bullestock/remote/mainboard-split/mainboard.kicad_pcb

## KiCad design mainboard-split/mainboard.kicad_pcb (2024-12-09)

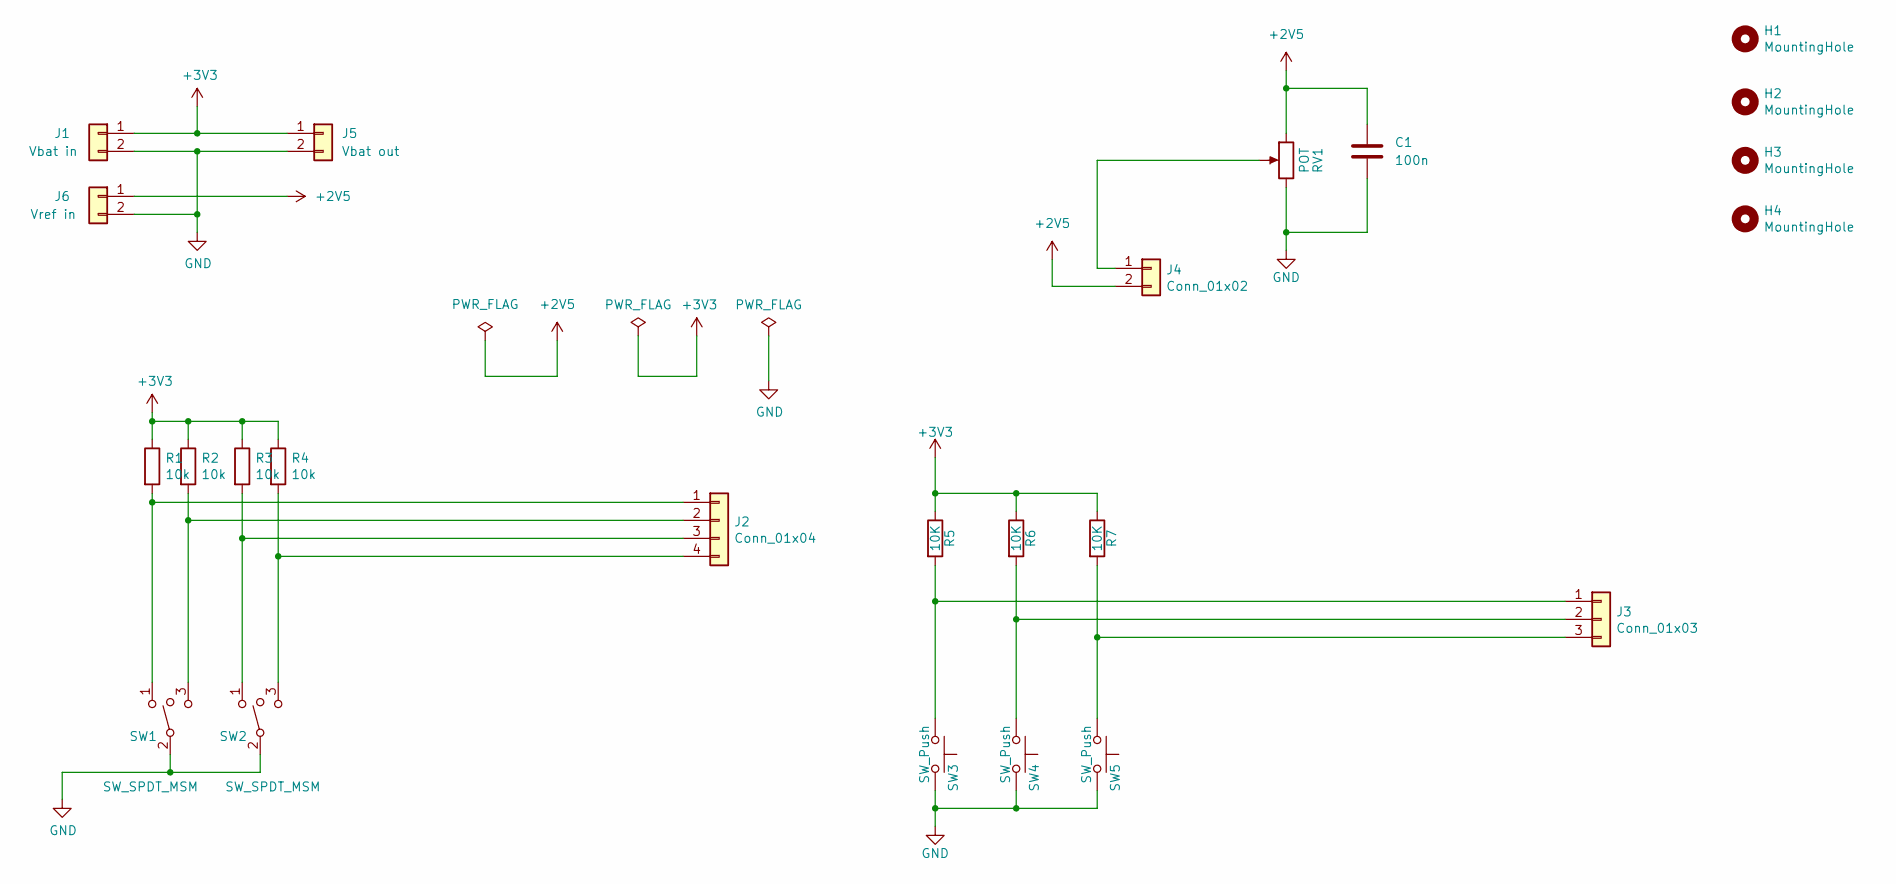
[picture p1: schematic mainboard.kicad_sch]

Parts:
C1: 100n; C_0603_1608Metric
H1, H2, H3, H4: MountingHole; MountingHole_3.2mm_M3
J1: Vbat in; JST_XH_B02B-XH-A_1x02_P2.50mm_Vertical
J2: Conn_01x04; JST_XH_B04B-XH-A_1x04_P2.50mm_Vertical
J3: Conn_01x03; JST_XH_B03B-XH-A_1x03_P2.50mm_Vertical
J4: Conn_01x02; JST_XH_B02B-XH-A_1x02_P2.50mm_Vertical
J5: Vbat out; JST_XH_B02B-XH-A_1x02_P2.50mm_Vertical
J6: Vref in; JST_XH_B02B-XH-A_1x02_P2.50mm_Vertical
R1, R2, R3, R4: 10k; R_0603_1608Metric
R5, R6, R7: 10K; R_0603_1608Metric
RV1: POT; Potentiometer_6mm_axis_square
SW1, SW2: SW_SPDT_MSM; Switch_1x03_P5.08mm
SW3, SW4, SW5: SW_Push; Switch_1x02_P6mm

Connections:
+2V5: C1.1, J4.2, J6.1, RV1.1
+3V3: J1.1, J5.1, R1.1, R2.1, R3.1, R4.1, R5.1, R6.1, R7.1
GND: C1.2, J1.2, J5.2, J6.2, RV1.3, SW1.2, SW2.2, SW3.2, SW4.2, SW5.2
unnamed: J2.1, R1.2, SW1.1
unnamed: J2.2, R2.2, SW1.3
unnamed: J2.3, R3.2, SW2.1
unnamed: J2.4, R4.2, SW2.3
unnamed: J3.1, R5.2, SW3.1
unnamed: J3.2, R6.2, SW4.1
unnamed: J3.3, R7.2, SW5.1
unnamed: J4.1, RV1.2

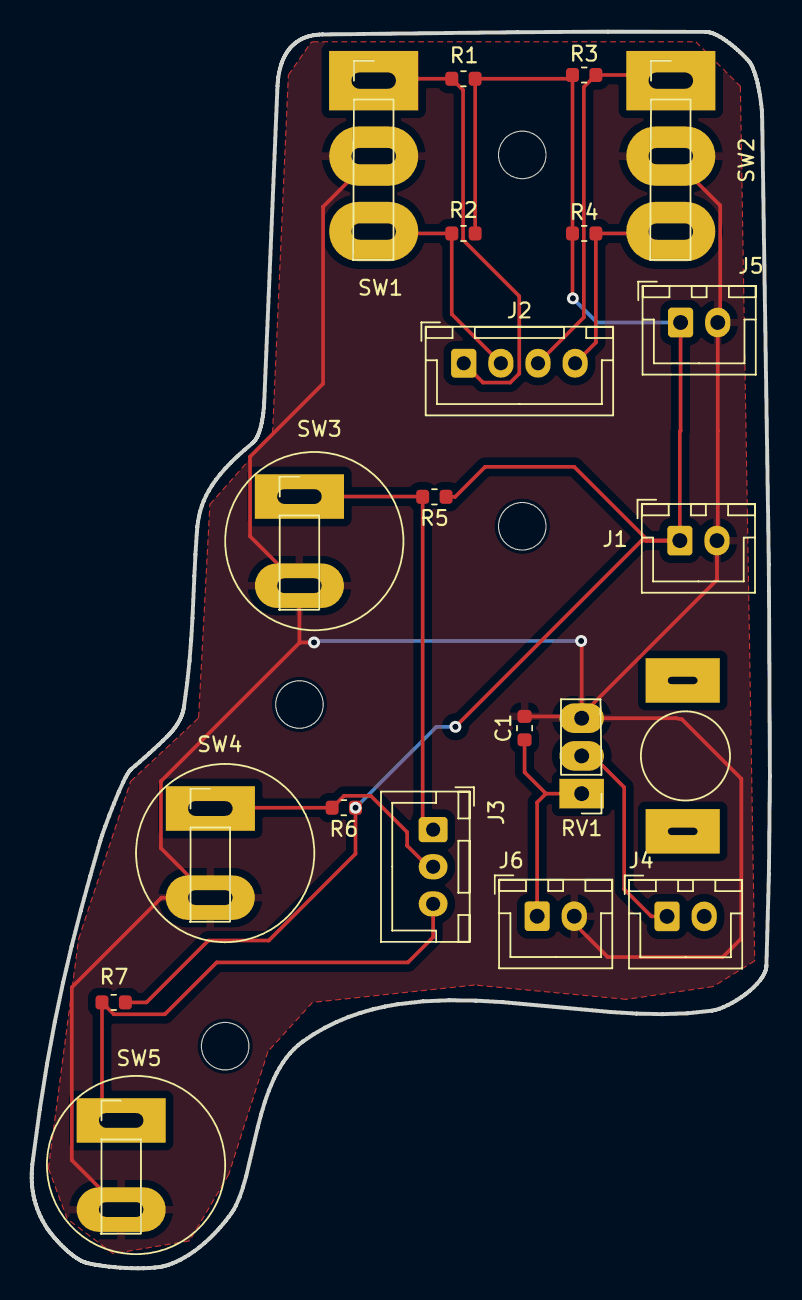
[picture p2: board mainboard.kicad_pcb from above]

Board: 2 copper layers, 49.7 x 83.3 mm, 24 parts (0 on the bottom side), 11 nets.
