bullestock/remote/controller/remote.kicad_pcb

## KiCad design controller/remote.kicad_pcb (2024-11-03)

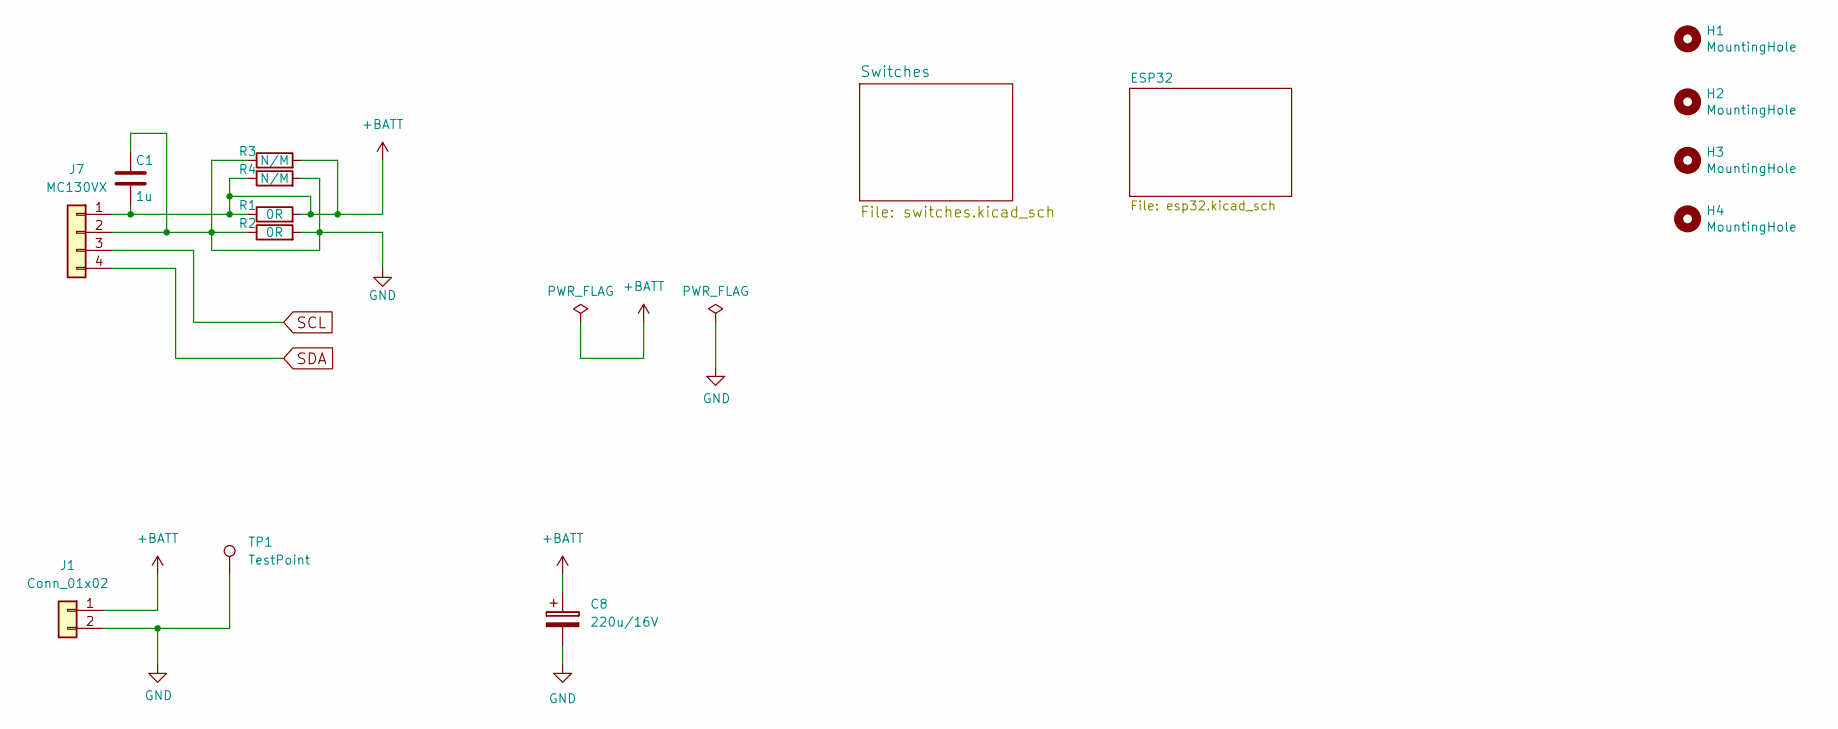
[picture p3: schematic remote.kicad_sch]

Parts:
C1: 1u; C_0603_1608Metric
C8: 220u/16V; CP_Elec_10x10.5
H1, H2, H3, H4: MountingHole; MountingHole_3.2mm_M3
J1: Conn_01x02; JST_XH_B02B-XH-A_1x02_P2.50mm_Vertical
J7: MC130VX; PinSocket_1x04_P2.54mm_Vertical
R1, R2: 0R; R_0603_1608Metric
R3, R4: N/M; R_0603_1608Metric
TP1: TestPoint; TestPoint_Keystone_5000-5004_Miniature

Connections:
+BATT: C1.2, C8.1, J1.1, J7.1, R1.1, R1.2, R3.2, R4.1; also elsewhere on the board
GND: C1.1, C8.2, J1.2, J7.2, R2.1, R2.2, R3.1, R4.2, TP1.1; also elsewhere on the board
SCL: J7.3; also elsewhere on the board
SDA: J7.4; also elsewhere on the board

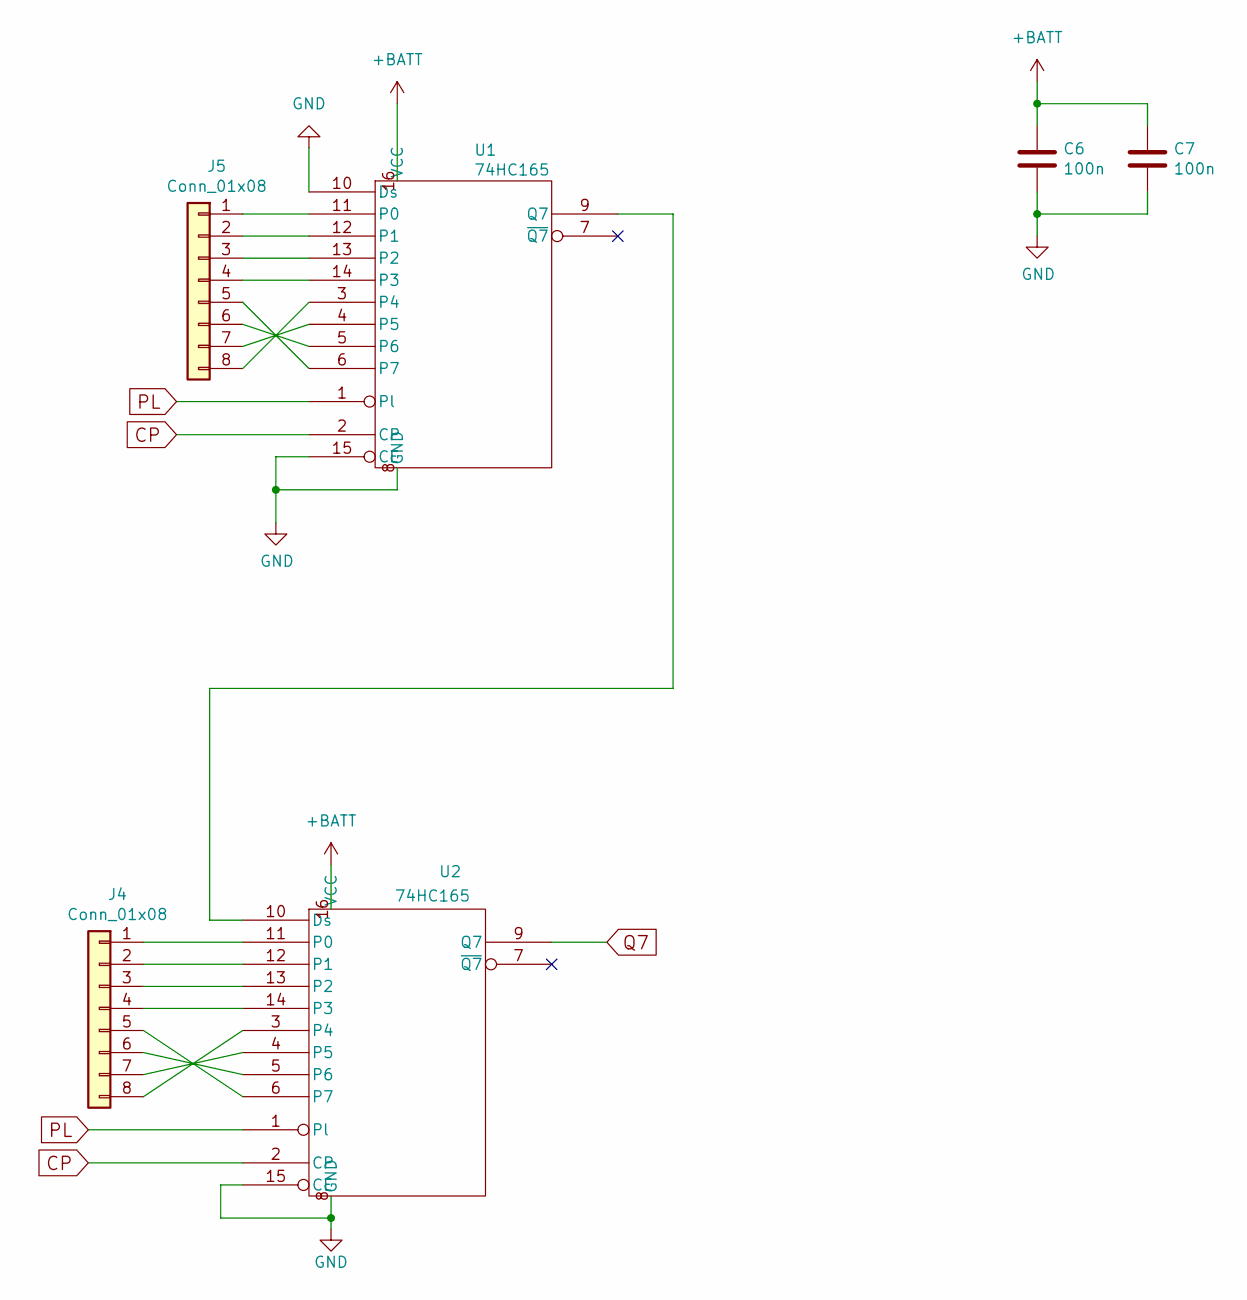
[picture p4: schematic switches.kicad_sch]

Parts:
C6, C7: 100n; C_0603_1608Metric
J4, J5: Conn_01x08; JST_XH_B08B-XH-A_1x08_P2.50mm_Vertical
U1, U2: 74HC165; SOP-16_3.9x9.9mm_P1.27mm

Connections:
+BATT: C6.1, C7.1, U1.16 (VCC), U2.16 (VCC); also elsewhere on the board
CP: U1.2 (CP), U2.2 (CP); also elsewhere on the board
GND: C6.2, C7.2, U1.8 (GND), U1.10 (Ds), U1.15 (CE), U2.8 (GND), U2.15 (CE); also elsewhere on the board
unnamed: J4.1, U2.11 (P0)
unnamed: J4.2, U2.12 (P1)
unnamed: J4.3, U2.13 (P2)
unnamed: J4.4, U2.14 (P3)
unnamed: J4.5, U2.6 (P7)
unnamed: J4.6, U2.5 (P6)
unnamed: J4.7, U2.4 (P5)
unnamed: J4.8, U2.3 (P4)
unnamed: J5.1, U1.11 (P0)
unnamed: J5.2, U1.12 (P1)
unnamed: J5.3, U1.13 (P2)
unnamed: J5.4, U1.14 (P3)
unnamed: J5.5, U1.6 (P7)
unnamed: J5.6, U1.5 (P6)
unnamed: J5.7, U1.4 (P5)
unnamed: J5.8, U1.3 (P4)
unnamed: U1.9 (Q7), U2.10 (Ds)
PL: U1.1 (Pl), U2.1 (Pl); also elsewhere on the board
Q7: U2.9 (Q7); also elsewhere on the board

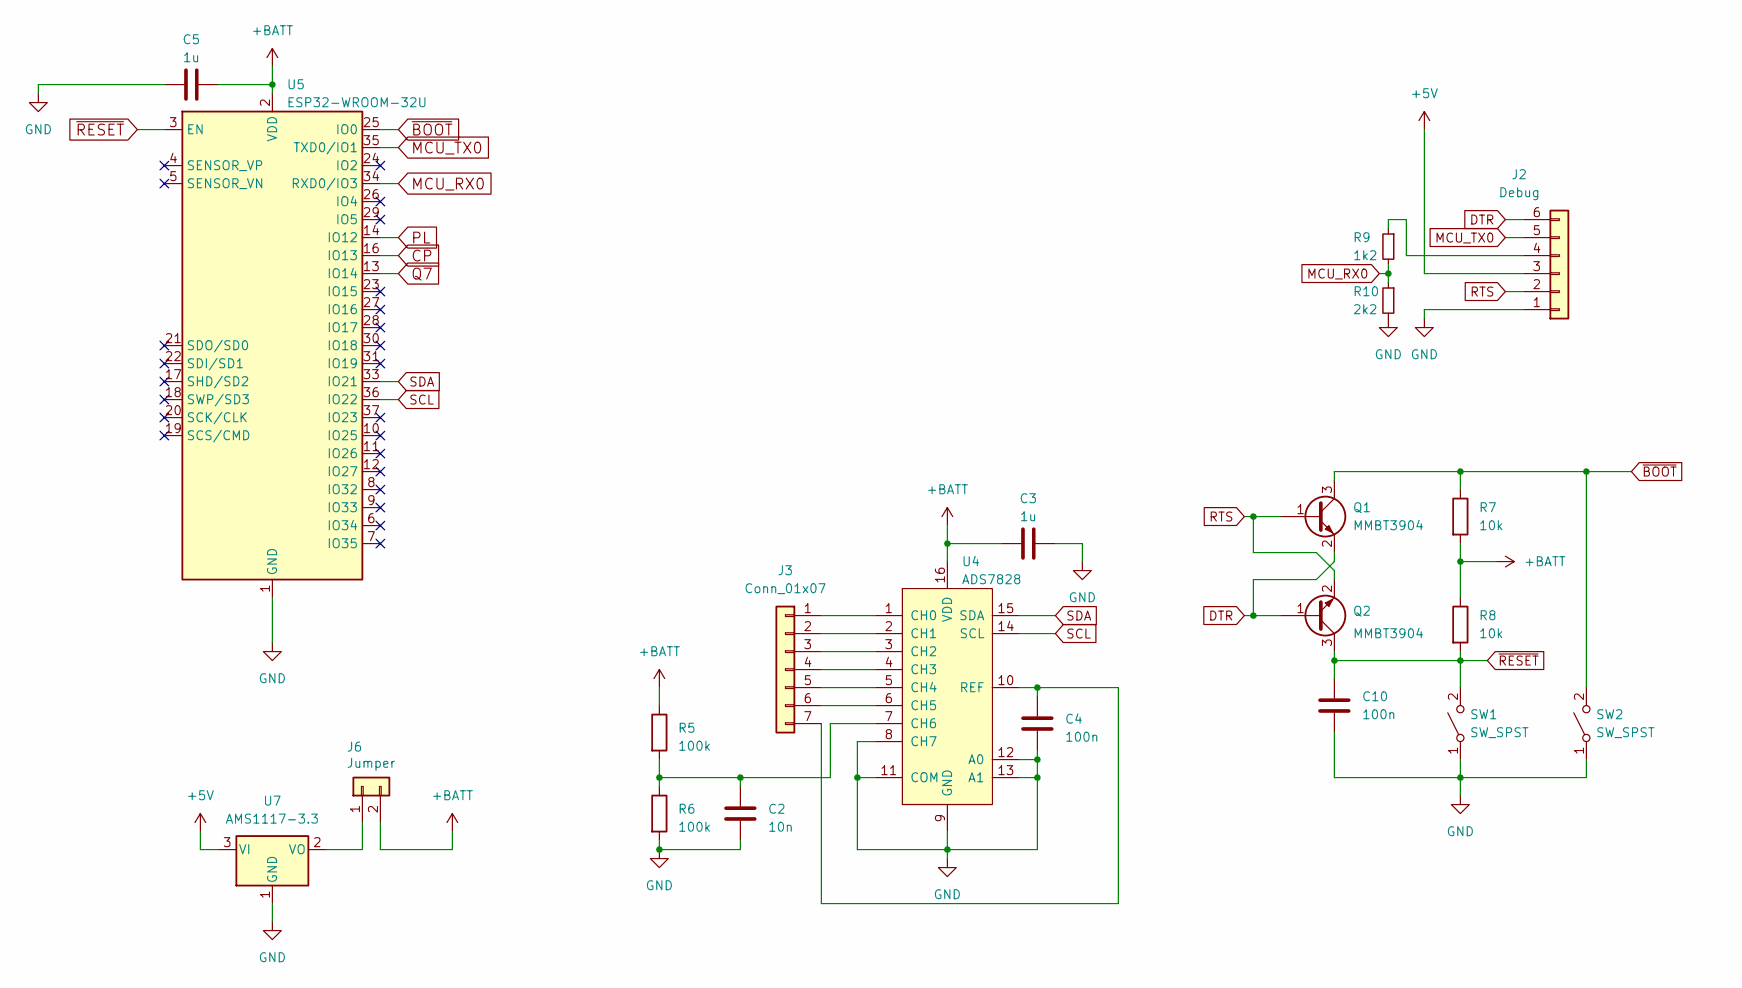
[picture p5: schematic esp32.kicad_sch]

Parts:
C2: 10n; C_0603_1608Metric
C3, C5: 1u; C_0603_1608Metric
C4, C10: 100n; C_0603_1608Metric
J2: Debug; PinHeader_1x06_P2.54mm_Vertical
J3: Conn_01x07; JST_XH_B07B-XH-A_1x07_P2.50mm_Vertical
J6: Jumper; PinHeader_1x02_P2.54mm_Vertical
Q1, Q2: MMBT3904; SOT-23
R5, R6: 100k; R_0603_1608Metric
R7, R8: 10k; R_0603_1608Metric
R9: 1k2; R_0603_1608Metric
R10: 2k2; R_0603_1608Metric
SW1, SW2: SW_SPST; SW_SPST_CK_RS282G05A3
U4: ADS7828; TSSOP-16_4.4x5mm_P0.65mm
U5: ESP32-WROOM-32U
U7: AMS1117-3.3; SOT-223-3_TabPin2

Connections:
+5V: J2.3, U7.3 (VI)
+BATT: C3.1, C5.2, J6.2, R5.1, R7.2, R8.1, U4.16 (VDD), U5.2 (VDD); also elsewhere on the board
CP: U5.16 (IO13); also elsewhere on the board
DTR: J2.6, Q1.2 (E), Q2.1 (B)
GND: C2.2, C3.2, C4.2, C5.1, C10.2, J2.1, R6.2, R10.2, SW1.1 (A), SW2.1 (A), U4.8 (CH7), U4.9 (GND), U4.11 (COM), U4.12 (A0), U4.13 (A1), U5.1 (GND), U5.15 (GND), U5.38 (GND), U5.39 (GND), U7.1 (GND); also elsewhere on the board
MCU_RX0: R9.2, R10.1, U5.34 (RXD0/IO3)
MCU_TX0: J2.5, U5.35 (TXD0/IO1)
unnamed: J2.4, R9.1
unnamed: J3.1, U4.1 (CH0)
unnamed: J3.2, U4.2 (CH1)
unnamed: J3.3, U4.3 (CH2)
unnamed: J3.4, U4.4 (CH3)
unnamed: J3.5, U4.5 (CH4)
unnamed: J3.6, U4.6 (CH5)
unnamed: C4.1, J3.7, U4.10 (REF)
unnamed: J6.1, U7.2 (VO)
unnamed: C2.1, R5.2, R6.1, U4.7 (CH6)
PL: U5.14 (IO12); also elsewhere on the board
Q7: U5.13 (IO14); also elsewhere on the board
RTS: J2.2, Q1.1 (B), Q2.2 (E)
SCL: U4.14 (SCL), U5.36 (IO22); also elsewhere on the board
SDA: U4.15 (SDA), U5.33 (IO21); also elsewhere on the board
~BOOT: Q1.3 (C), R7.1, SW2.2 (B), U5.25 (IO0)
~RESET: C10.1, Q2.3 (C), R8.2, SW1.2 (B), U5.3 (EN)

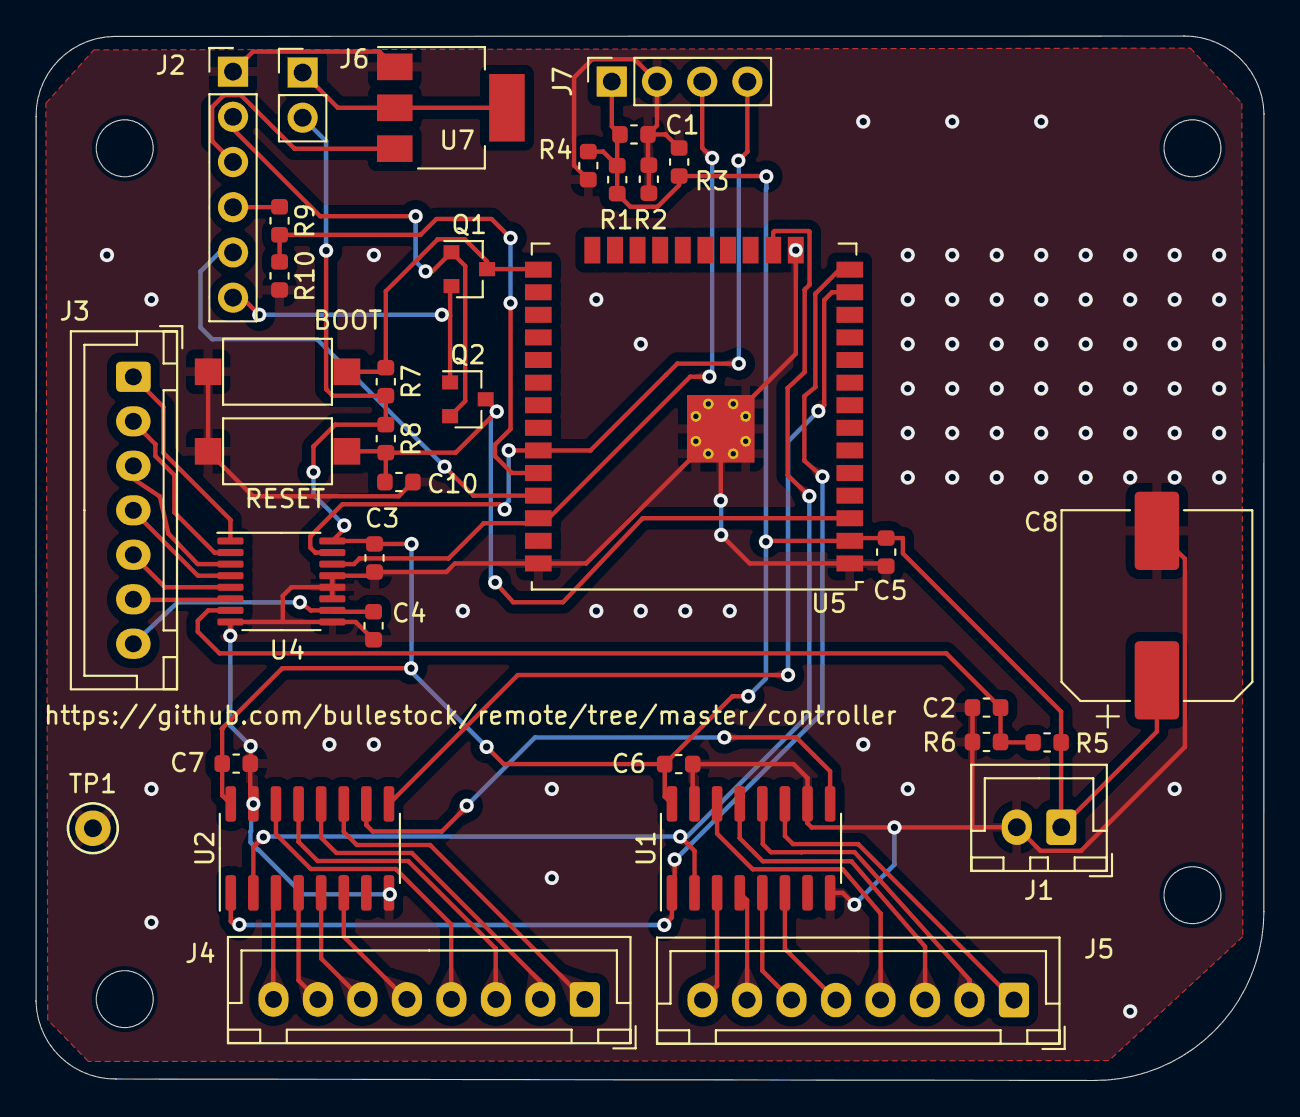
[picture p6: board controller/remote.kicad_pcb from above]

Board: 2 copper layers, 69.0 x 58.7 mm, 40 parts (0 on the bottom side), 41 nets.
