bullestock/remote/mainboard/remote.kicad_pcb

## KiCad design mainboard/remote.kicad_pcb (2024-06-08)

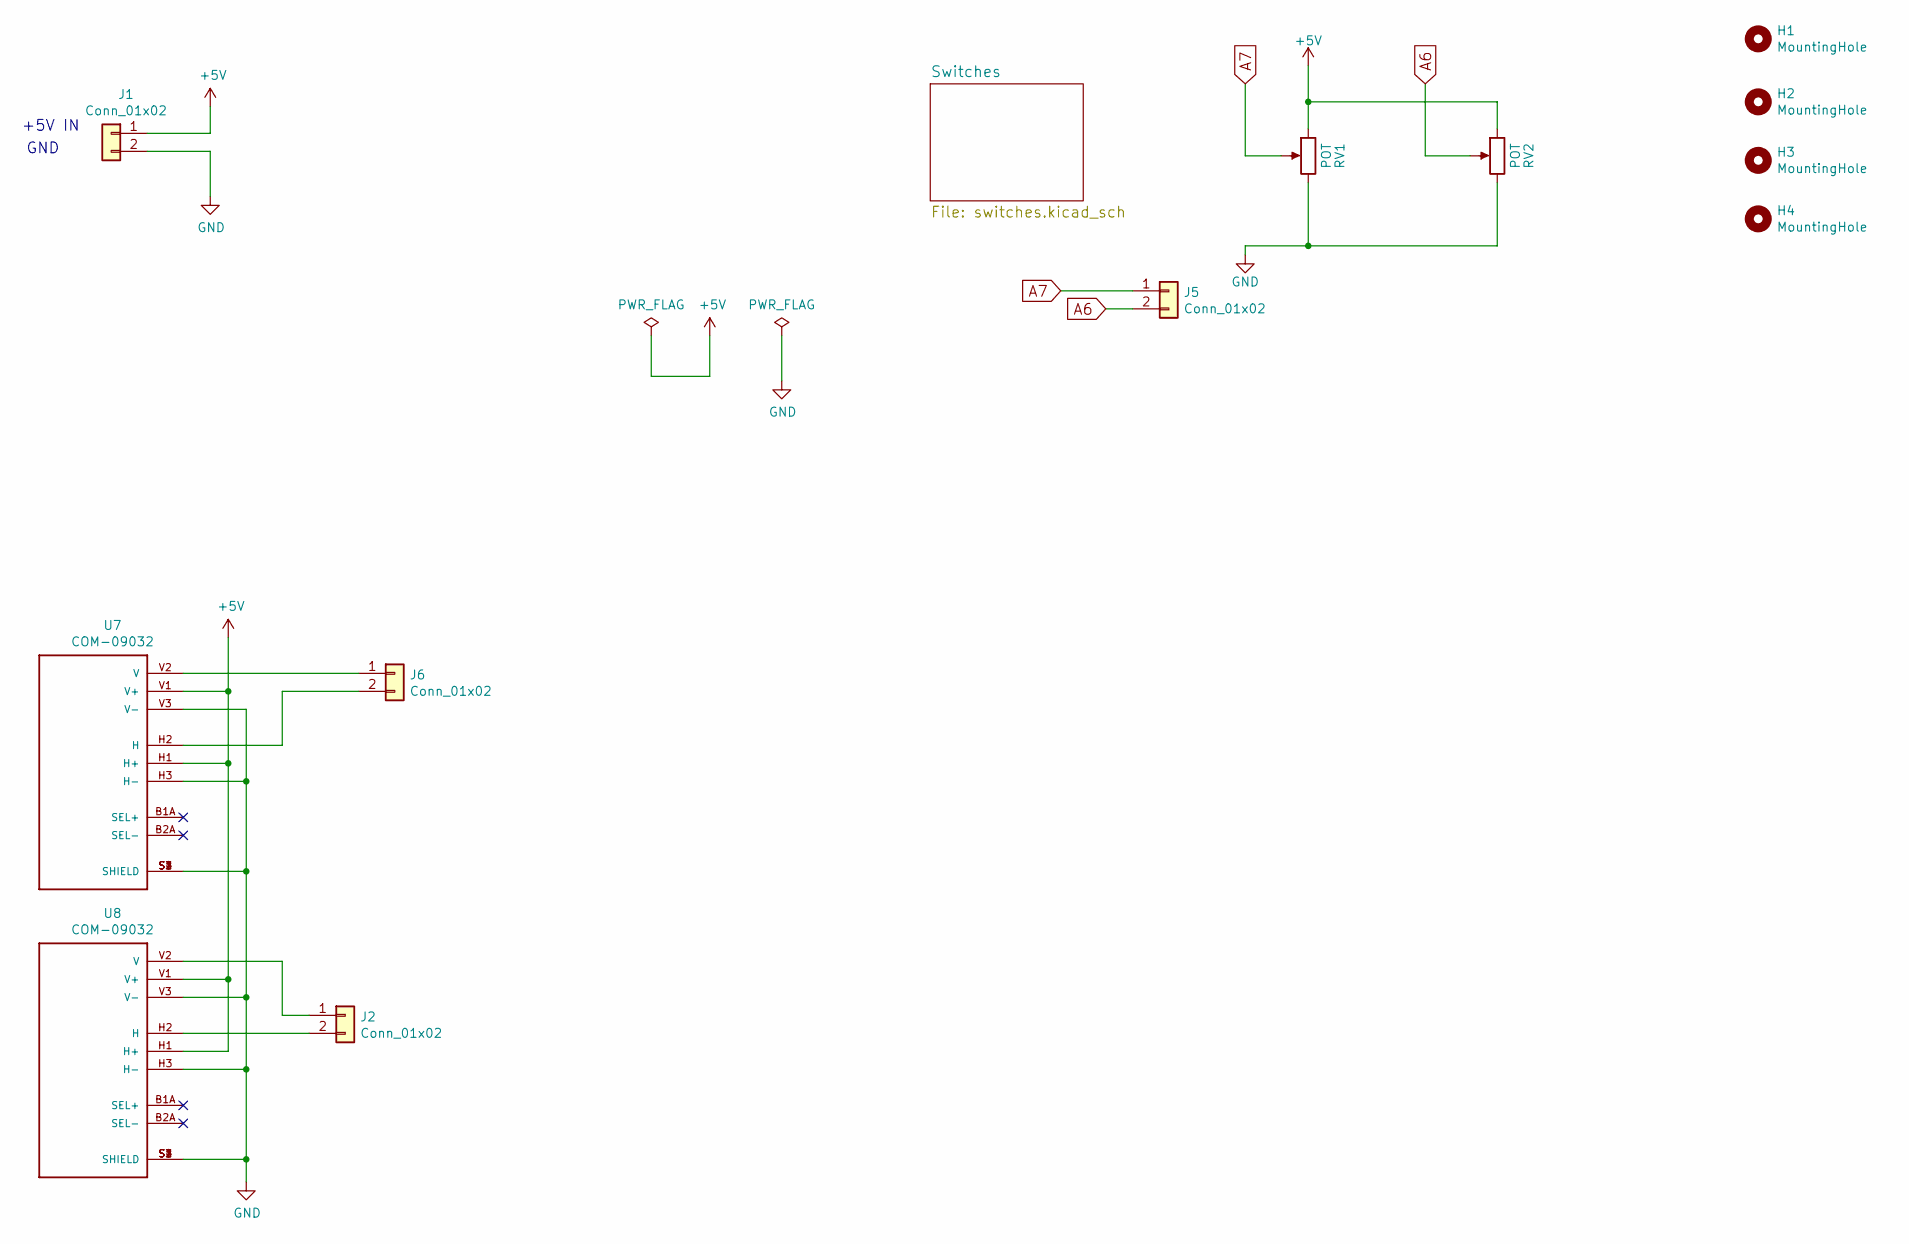
[picture p7: schematic remote.kicad_sch]

Parts:
H1, H2, H3, H4: MountingHole; MountingHole_3.2mm_M3
J1, J2, J5, J6: Conn_01x02; JST_XH_B02B-XH-A_1x02_P2.50mm_Vertical_Milling
RV1, RV2: POT; Potentiometer_6mm_axis_square
U7, U8: COM-09032; AnalogJoystick_ALPS_10k

Connections:
+5V: J1.1, RV1.1, RV2.1, U7.H1 (H+), U7.V1 (V+), U8.H1 (H+), U8.V1 (V+); also elsewhere on the board
A6: J5.2, RV2.2
A7: J5.1, RV1.2
GND: J1.2, RV1.3, RV2.3, U7.H3 (H-), U7.S1 (SHIELD), U7.S2 (SHIELD), U7.S3 (SHIELD), U7.S4 (SHIELD), U7.V3 (V-), U8.H3 (H-), U8.S1 (SHIELD), U8.S2 (SHIELD), U8.S3 (SHIELD), U8.S4 (SHIELD), U8.V3 (V-); also elsewhere on the board
unnamed: J2.1, U8.V2 (V)
unnamed: J2.2, U8.H2 (H)
unnamed: J6.1, U7.V2 (V)
unnamed: J6.2, U7.H2 (H)

Notes on the sheet:
GND
+5V IN

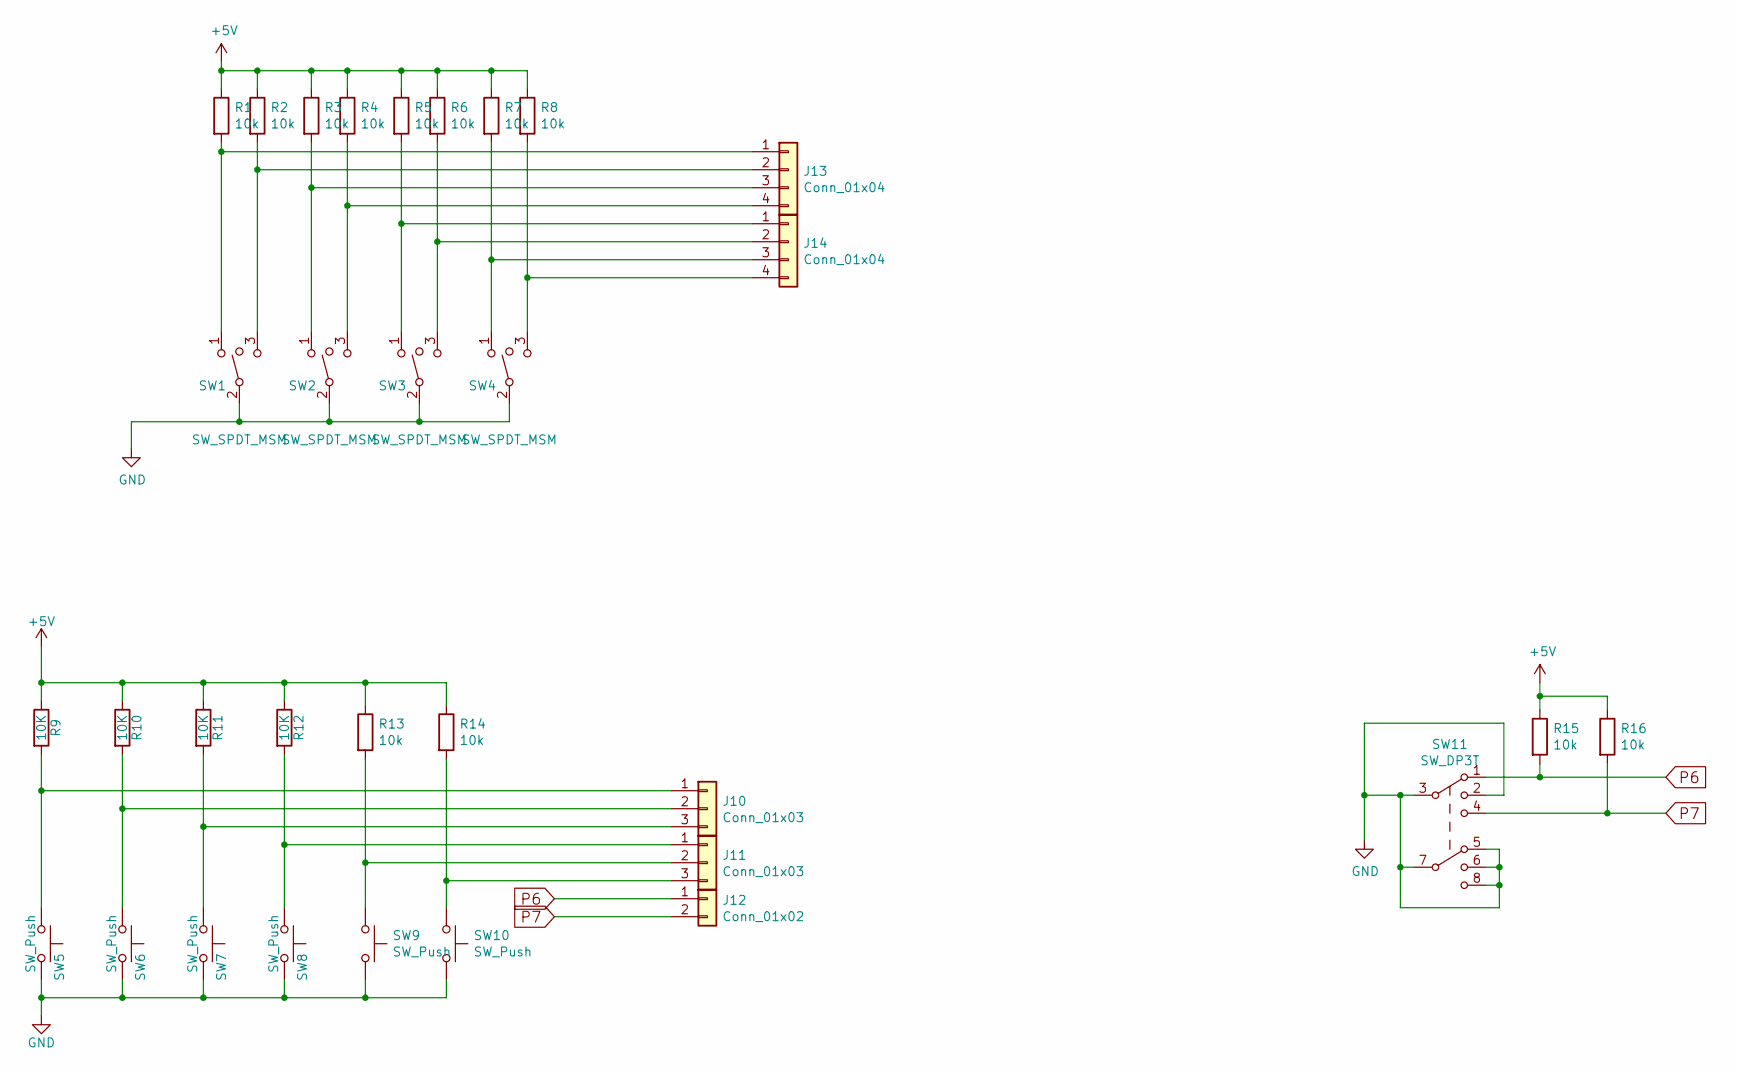
[picture p8: schematic switches.kicad_sch]

Parts:
J10, J11: Conn_01x03; JST_XH_B03B-XH-A_1x03_P2.50mm_Vertical_Milling
J12: Conn_01x02; JST_XH_B02B-XH-A_1x02_P2.50mm_Vertical_Milling
J13, J14: Conn_01x04; JST_XH_B04B-XH-A_1x04_P2.50mm_Vertical_Milling
R1, R2, R3, R4, R5, R6, R7, R8, R13, R14, R15, R16: 10k; R_0805_2012Metric
R9, R10, R11, R12: 10K; R_0805_2012Metric
SW1, SW2, SW3, SW4: SW_SPDT_MSM; Switch_1x03_P5.08mm
SW5, SW6, SW7, SW8, SW9, SW10: SW_Push; Switch_1x02_P6mm
SW11: SW_DP3T; Switch_2x03_P3mm_Slide

Connections:
+5V: R1.1, R2.1, R3.1, R4.1, R5.1, R6.1, R7.1, R8.1, R9.1, R10.1, R11.1, R12.1, R13.1, R14.1, R15.1, R16.1; also elsewhere on the board
GND: SW1.2, SW2.2, SW3.2, SW4.2, SW5.2, SW6.2, SW7.2, SW8.2, SW9.2, SW10.2, SW11.2, SW11.3, SW11.5, SW11.6, SW11.7, SW11.8; also elsewhere on the board
unnamed: J10.1, R9.2, SW5.1
unnamed: J10.2, R10.2, SW6.1
unnamed: J10.3, R11.2, SW7.1
unnamed: J11.1, R12.2, SW8.1
unnamed: J11.2, R13.2, SW9.1
unnamed: J11.3, R14.2, SW10.1
unnamed: J13.1, R1.2, SW1.1
unnamed: J13.2, R2.2, SW1.3
unnamed: J13.3, R3.2, SW2.1
unnamed: J13.4, R4.2, SW2.3
unnamed: J14.1, R5.2, SW3.1
unnamed: J14.2, R6.2, SW3.3
unnamed: J14.3, R7.2, SW4.1
unnamed: J14.4, R8.2, SW4.3
P6: J12.1, R15.2, SW11.1
P7: J12.2, R16.2, SW11.4

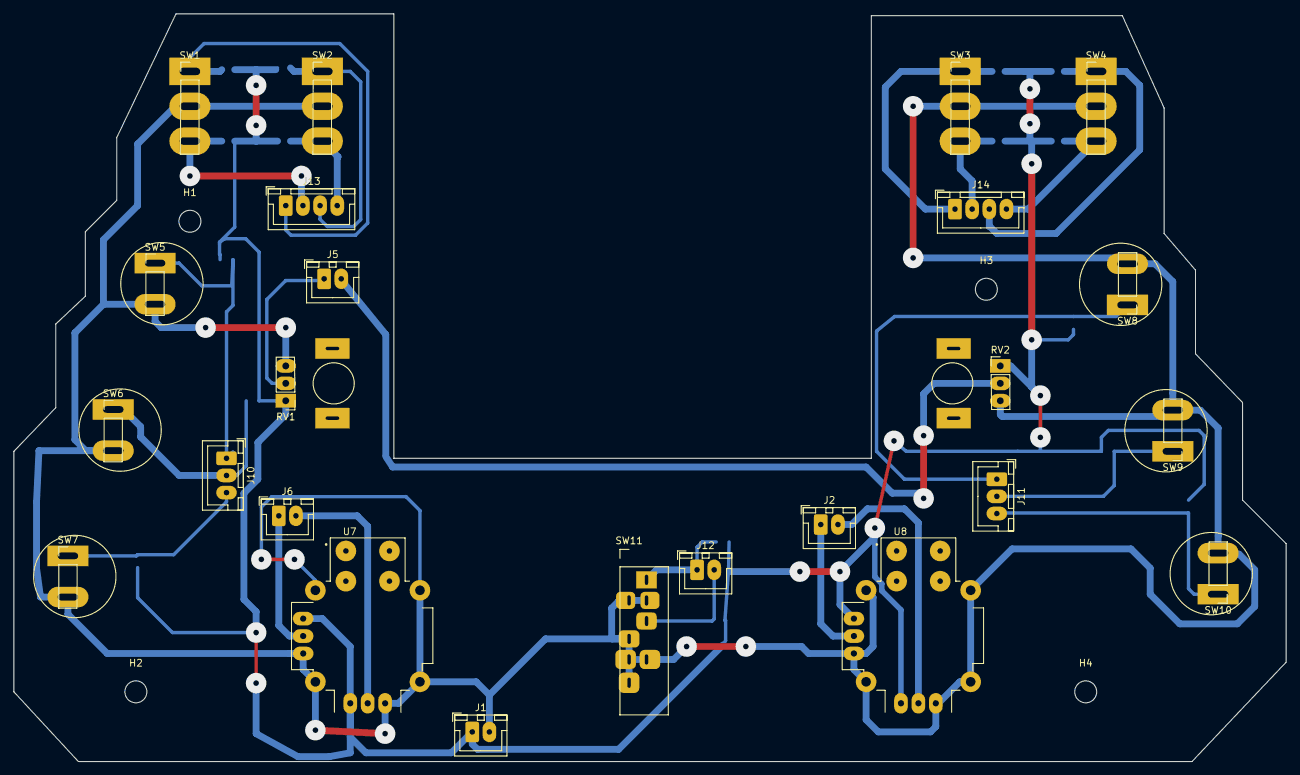
[picture p9: board mainboard/remote.kicad_pcb from above]

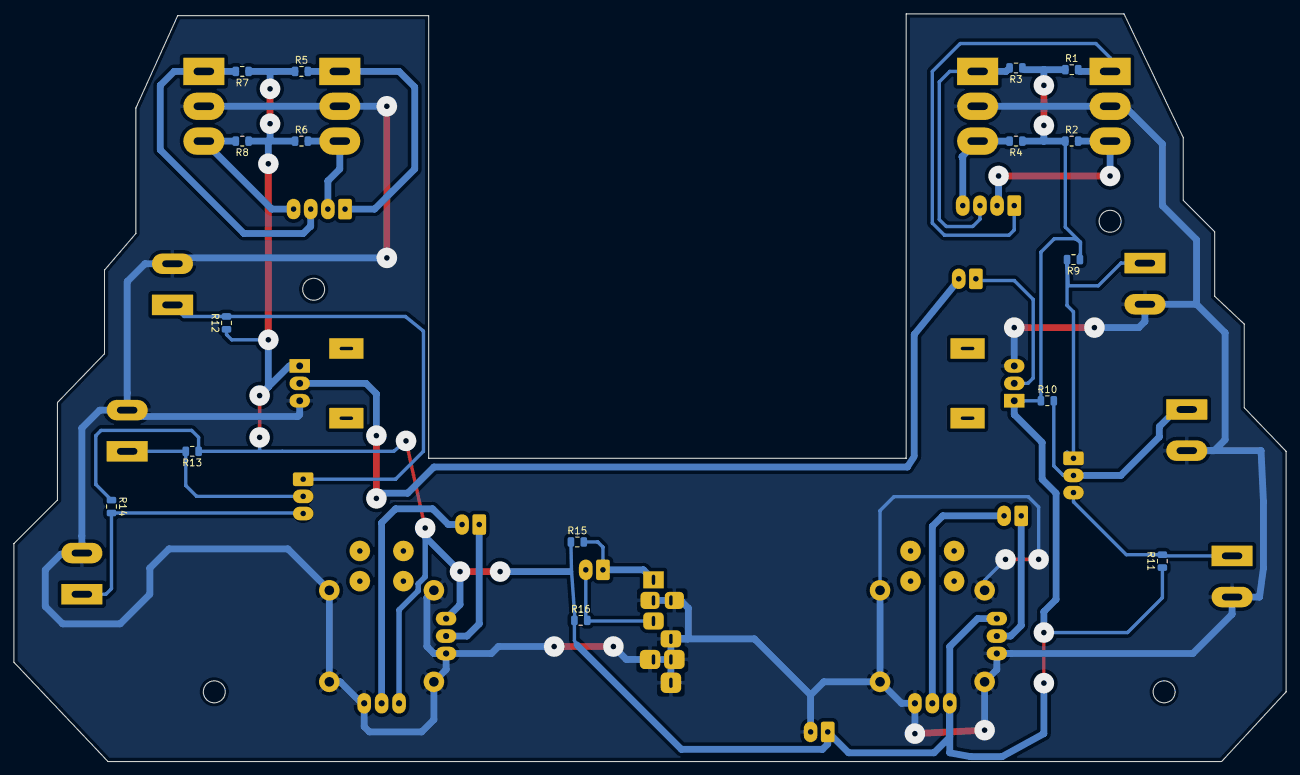
[picture p10: board mainboard/remote.kicad_pcb from below]

Board: 2 copper layers, 185.4 x 109.0 mm, 44 parts (16 on the bottom side), 24 nets.
