bullestock/remote/(commit log)

2017-08-09 Air frame format.
2017-08-09 Update diagram.
    [remote.sch]
2017-08-12 Read switches.
2017-08-12 Fix pin numbering.
2017-08-12 Add switches field.
2017-08-12 Fix pin use.
    [remote.sch]
2017-08-19 Do not set .switches to 0.
2017-08-21 Set power level to max. Adjust node addresses. Clean up statistics display.
2017-09-20 Enlarge hole.
2017-09-20 Add battery voltage to protocol.
2017-10-01 Show number of CRC errors.
    [firmware.ino]
2020-01-25 Prepare for PCB.
    [remote.kicad_pcb, remote.sch, switches.sch]
2020-01-26 Add more switches, footprints.
    [remote.kicad_pcb, remote.sch, switches.sch]
2020-01-26 Place switches, etc. Split up into two boards.
    [remote.kicad_pcb, remote.sch, switches.sch]
2020-01-27 Work on layout.
    [remote.kicad_pcb]
2020-01-31 Split into two projects.
    [remote-2019-06-30-17-53-40.sch, remote-2020-01-25-20-49-44.sch, remote.kicad_pcb, remote.sch, switches-2019-06-30-17-53-40.sch, switches-2020-01-25-20-49-44.sch, switches.sch]
2020-01-31 Update for I2C display.
    [remote.kicad_pcb, remote.sch, switches.sch]
2020-01-31 Update to 4-pin I2C display.
    [remote.kicad_pcb, remote.sch, switches.sch]
2020-02-01 Fix joystick footprint.
    [remote.kicad_pcb, remote.sch]
2020-02-01 Fix toggle footprints.
    [remote.kicad_pcb]
2020-02-01 Update slide switch footprint.
    [remote.kicad_pcb]
2020-02-01 Update holes in switch footprints.
    [remote.kicad_pcb]
2020-02-01 Move jumper.
    [remote.kicad_pcb]
2020-02-02 Add slide switch depression.
2020-02-07 Make slide switch cover separate.
2020-02-07 Make joystick cover a separate piece; add PCB standoffs.
2020-02-08 Adjust pot holes.
2020-02-08 Make PCB supports thicker.
2020-02-08 Offset holes.
2020-02-08 Move PCB mounts along with holes.
2020-02-09 Add screw studs.
2020-02-09 Fix upper screw studs.
2020-02-09 Fix right screw stud.
2020-02-15 Add PCB supports and studs.
2020-02-20 Add charger hole etc.
2020-02-20 Add tabs for fixing charger.
2020-02-21 Adjust slide switch position.
2020-02-21 Adapt for new-style joystick/switch.
2020-02-22 Make slide hole wider.
2020-02-29 Add antenna hole.
2020-02-29 Add controller screw studs, determine overall height.
2020-02-29 Change LiPo to 500 mAh.
2020-02-29 Add tab for antenna hole.
2020-03-01 Add insert holes to mainboard studs.
2020-03-01 Make screwstud() independt of th, add insert hole.
2020-03-01 Make pcbsupport() independt of th.
2020-03-01 Make PCB supports conical, increase height.
2020-03-01 Increase thickness, fix display and antenna holes.
2020-03-03 Fix antenna hole.
2020-03-03 Increase lipo length.
2020-03-03 Make charger hole oval.
2020-03-03 Make PCB supports stronger.
2020-03-03 Lower antenna.
2020-03-03 Make screw studs conical.
2020-03-03 Add one more PCB support.
2020-03-22 Update for new controller board, and SH1106 display.
2020-03-23 Make a local copy of SH1106 driver.
2020-03-23 Remove SPI support.
2020-03-26 Fix reading of switches.
    [firmware.ino]
2020-03-26 Use all bits for switches.
2020-07-17 Split switches into separate member vars.
2020-07-17 Enlarge stud holes a bit.
2020-07-17 Remove holes.
2020-07-17 Update schematic.
    [remote.kicad_pcb, remote.sch]
2023-05-18 Start migration to ESP32.
    [esp32.kicad_sch, remote.kicad_pcb, remote.kicad_sch, switches.kicad_sch]
2023-05-20 Add debug connector.
    [esp32.kicad_sch, remote.kicad_sch, switches.kicad_sch]
2023-05-25 Work on routing.
    [remote.kicad_pcb, remote.kicad_sch]
2023-05-28 Complete routing.
    [remote.kicad_pcb, remote.kicad_sch]
2023-06-29 Fix capacitor values.
    [esp32.kicad_sch, remote.kicad_pcb, remote.kicad_sch]
2024-04-09 Add switches, regulator, etc.
    [esp32.kicad_sch, remote.kicad_pcb, remote.kicad_sch, switches.kicad_sch]
2024-04-09 Move nRF footprint.
    [remote.kicad_pcb]
2024-04-09 Finish routing.
    [remote.kicad_pcb, remote.kicad_sch]
2024-04-13 Add nRF mounting screw.
    [remote.kicad_pcb, remote.kicad_sch]
2024-05-02 Update KiCAD version.
    [esp32.kicad_sch, remote.kicad_pcb, remote.kicad_sch, switches.kicad_sch]
2024-05-05 Init HW.
    [esp32.kicad_sch]
2024-05-05 Implement ADC read.
2024-05-06 Possibly fix ADC read.
    [hw.cpp]
2024-05-08 Add test point.
    [remote.kicad_pcb, remote.kicad_sch, switches.kicad_sch]
2024-05-09 Add display driver.
2024-05-10 Spacer for display header.
2024-05-18 Add I2C scan command.
2024-05-20 Fix read_adc() return value.
    [console.cpp, hw.cpp]
2024-05-21 Add lasercut front.
2024-05-27 Add split mainboard PCB.
    [remote.kicad_pcb, remote.kicad_sch]
2024-05-28 Add more power.
    [remote.kicad_pcb, remote.kicad_sch]
2024-05-28 Rename project.
    [mainboard.kicad_pcb, mainboard.kicad_sch]
2024-06-03 Place switches on millimeter grid.
    [mainboard.kicad_pcb]
2024-06-03 Improve outline.
    [mainboard.kicad_pcb]
2024-06-06 Fix JST 3D models.
    [mainboard.kicad_pcb]
2024-06-06 Fix more models.
    [mainboard.kicad_pcb]
2024-06-06 Add fills.
    [mainboard.kicad_pcb, mainboard.kicad_sch]
2024-06-08 Enlarge stick lock holes.
2024-06-08 Order PCB.
    [mainboard.kicad_pcb, remote.kicad_pcb, remote.sch, switches.sch]
2024-07-13 Fix read of switches.
    [hw.cpp]
2024-07-13 Add support for reading all ADC channels.
2024-07-13 Update for new PCB.
2024-07-14 Add controller standoffs.
2024-07-14 Add mainboard standoffs.
2024-07-16 Adjust PCB positions, add antenna cutouts.
2024-07-16 Add charging port.
2024-07-22 Fix mainboard standoff positions.
2024-07-22 Add screwposts.
2024-07-27 Make room for lid screwposts.
2024-08-10 Use magnet instead of screw.
2024-08-10 Adjust display hole.
2024-08-10 Fix screwposts, add pushbutton holes.
2024-08-10 Add toggle switch holes.
2024-08-10 Add pot, joystick holes.
2024-08-10 Add joystick screw holes.
2024-08-10 Add remaining holes.
2024-08-11 Mount for charger module.
2024-08-11 Mount for SMPS module.
2024-08-11 Box for 700 mAh LiPo battery.
2024-08-12 Lid for battery box.
2024-08-12 Increase insert hole diameter.
2024-09-01 Remove stray fills.
    [esp32.kicad_sch, remote.kicad_pcb, remote.kicad_sch, switches.kicad_sch]
2024-09-01 Add readout of slide switch.
2024-09-01 Put ADC Vref onto analog connector.
    [esp32.kicad_sch, remote.kicad_pcb]
2024-09-02 Fix analog channel assignments.
    [defs.h]
2024-09-02 Implement stick calibration.
2024-09-02 Clamp stick values.
2024-09-03 Tweak battery measurement.
2024-10-27 Use correct frame structure.
    [main.cpp, radio.cpp, radio.h]
2024-11-03 Remove nRF24L01.
    [esp32.kicad_sch, remote.kicad_pcb, remote.kicad_sch, switches.kicad_sch]
2024-11-03 Power directly from battery.
    [esp32.kicad_sch, remote.kicad_pcb, remote.kicad_sch, switches.kicad_sch]
2024-11-03 Add large decoupling cap.
    [remote.kicad_pcb, remote.kicad_sch]
2024-11-03 Make mounting R1/R2 optional.
    [remote.kicad_pcb, remote.kicad_sch]
2024-11-03 Fix missing trace.
    [remote.kicad_pcb]
2024-11-16 Fix bad format specifier.
    [main.cpp]
2024-11-16 Fix switched up/down for right side toggles.
    [hw.cpp]
2024-11-16 Add stick filtering.
2024-12-09 Use Vref for pots and sticks.
    [mainboard.kicad_pcb, mainboard.kicad_sch]
2024-12-13 Mount antenna in case wall.
2024-12-13 Move charging port to right side.
2024-12-16 Some charger modules are wider than others.
2025-01-03 Update display in separate thread.
2025-01-04 Check if display is present. Add sanity check for ADC values.
2025-01-07 Preload filter to improve zeroing.
2025-04-19 Add support for showing stick calibration.
2025-12-30 Remove old display driver component.
2026-01-02 Move power mapping to remote.
2026-05-31 Implement sound handling (browse still missing).
    [console.cpp, hw.cpp, hw.h, main.cpp]
2026-08-29 Avoid crash during init.
    [main.cpp]
2026-09-06 Make stick calibration easier.
